matthew-the-king/RTU-Rocket-Telemetry-Unit-/README.md

# RTU-Rocket-Telemetry-Unit-
The RTU(Rocket Telemetry Unit) is an all-in-one solution for logging and transmitting data, plus controlling up to 3 servos. 



## Specifications
The RTU contains the following:<br>
MCU: STM32H725RGV6<br>
Barometer: BMP581<br>
IMU: BMI270<br>

For Power, the RTU has a 3.3V regulator and a 5v regulator for servos.<br>


## Recording Data
The RTU can record data to an SD card, provided that an SD card is inserted into the SD card port.<br>

## Transmitting Data
The RTU can transmit data through an on-board LoRa module; you must connect the appropriate u.fl antenna to the antenna port for the module to transmit.<br>

## Servo Control
The RTU can control up to three 5V servos; the servo ports can be found in these locations:<br>


## Production 
|Designator |Footprint |Quantity|Value | Link | Price |
|---|---|---|---|---|---|
|C10, C12, C19, C28, C36, C40 |0603 |6 |1uF | [Link](https://www.digikey.com/en/products/detail/kemet/C0603C105K4RACTU/2199788) | $0.83(Cheaper to buy 10) | 
|C11, C29, C30, C37, C38, C39 |0603 |6 |10uF | [Link](https://www.digikey.com/en/products/detail/murata-electronics/GRT188R61C106KE13D/5416739) | $1.75(Cheaper to buy 10)|
|C13, C14, C15, C16, C17, C18, C21, C22, C27, C3, C32, C34, C35, C4, C42, C43, C5, C6, C7, C8, C9|0402 |21 |0.1uF | [Link](https://www.digikey.com/en/products/detail/murata-electronics/GCM155R71H104KE02D/4903704) | $0.74 |
|C2, C49, C50 |0603 |3 |22uF | [Link](https://www.digikey.com/en/products/detail/samsung-electro-mechanics/CL10A226MO7JZNC/7320581) | $2.40 |
|C20, C31, C41, C46, C47, C48 |CAP_E61_CHC |6 |100uF | [Link](https://www.digikey.com/en/products/detail/chemi-con/APXG160ARA101ME61G/3983370) | $4.26 |
|C23, C24 |0603 |2 |2.2uF | [Link](https://www.digikey.com/en/products/detail/murata-electronics/GRM188R71A225KE15D/1033256) | $0.32 |
|C25, C26 |0402 |2 |10pF | [Link](https://www.digikey.com/en/products/detail/murata-electronics/GRM1555C1H100FA01D/2543854) | $0.20 |
|C33 |0603 |1 |4.7uF | [Link](https://www.digikey.com/en/products/detail/murata-electronics/GRM188R61E475KE11D/3900465) | $0.26 |
|C44 |0603 |1 |4700pF | [Link](https://www.digikey.com/en/products/detail/murata-electronics/GRM1885C1H472JA01D/4421616) | $0.12 | 
|C45 |0402 |1 |100pF | [Link](https://www.digikey.com/en/products/detail/murata-electronics/GRM1555C1H101GA01D/3693920) | $0.11 |
|D1 |0805 |1 |LED | [Link](https://www.digikey.com/en/products/detail/liteon/LTST-C170GKT/269226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) | $0.17 |
|FB1 |0603 |1 |120R | [Link](https://www.digikey.com/en/products/detail/pulse-electronics/PE-0603PFB121ST/5050544) | $0.10 |
|FPWM1, PFM1, R15, R16, R6, R7 |0402 |6 |10kΩ | [Link](https://www.digikey.com/en/products/detail/yageo/RC0402JR-0710KL/726418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) | $0.21(Cheaper to buy 10) |
|J1 |GCT_MEM2075-00-140-01-A |1 |MEM2075-00-140-01-A | [Link](https://www.digikey.com/en/products/detail/gct/MEM2075-00-140-01-A/9859614) | $1.92 |
|J2 |SAMESKY_UJ20-C-H-G-SMT-P16-TR |1 |UJ20-C-H-G-SMT-1-P16-TR| [Link](https://www.digikey.com/en/products/detail/same-sky-formerly-cui-devices/UJ20-C-H-G-SMT-P16-TR/24818595) | $0.65 |
|J4 |JST_B6B-XH-A |1 |B6B-XH-A | [Link](https://www.digikey.com/en/products/detail/jst-sales-america-inc/B6B-XH-A/1000381) | $0.23 |
|J5 |JST_B4B-XH-A |1 |B4B-XH-A | [Link](https://www.digikey.com/en/products/detail/jst-sales-america-inc/B4B-XH-A/1651047) | $0.17 |
|L1 |1008 |1 |1uH | [Link](https://www.digikey.com/en/products/detail/murata-electronics/DFE252012P-1R0M-P2/5247258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) | $0.22 |
|L2 |L_Wurth_WE-LHCA-1040 |1 |4.7uH | [Link](https://www.digikey.com/en/products/detail/w%C3%BCrth-elektronik/784373680047/24774011) | $3.35 |
|R1, R2 |0402 |2 |5.1kΩ | [Link](https://www.digikey.com/en/products/detail/yageo/RC0402FR-075K1L/726624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) | $0.20 |
|R10 |0402 |1 |330Ω | [Link](https://www.digikey.com/en/products/detail/yageo/RC0402FR-07330RL/726594) | $0.10 |
|R11, R12, R4, R5 |0402 |4 |4.7kΩ | [Link](https://www.digikey.com/en/products/detail/yageo/RC0402JR-074K7L/726477) | $0.21(Cheaper to buy 10) |
|R13 |0402 |1 |27.4kΩ | [Link](https://www.digikey.com/en/products/detail/yageo/RC0402FR-0727K4L/2827587) | $0.10 |
|R14 |0402 |1 |23.2kΩ | [Link](https://www.digikey.com/en/products/detail/panasonic-industry/ERJ-2RKF2322X/192235) | $0.10 |
|R3 |0402 |1 |0Ω | [Link](https://www.digikey.com/en/products/detail/panasonic-industry/ERJ-2GE0R00X/146727) | $0.10 |
|R8 |0603 |1 |511kΩ | [Link](https://www.digikey.com/en/products/detail/yageo/RC0603FR-07511KL/727288) | $0.10 |
|R9 |0603 |1 |91kΩ | [Link](https://www.digikey.com/en/products/detail/yageo/RC0603JR-0791KL/726841) | $0.10 |
|U1 |QFN-68-1EP_8x8mm_P0.4mm_EP6.4x6.4mm |1 |STM32H725RGVx | [Link](https://www.digikey.com/en/products/detail/stmicroelectronics/STM32H725RGV6/18085383) | $14.22 |
|U2 |QFN10_BMP581_BOS |1 |BMP581 | [Link](https://www.digikey.com/en/products/detail/bosch-sensortec/BMP581/16036134) | $3.35 |
|U3 |XDCR_BMI270 |1 |BMI270 | [Link](https://www.digikey.com/en/products/detail/bosch-sensortec/BMI270/9974486) | $4.23 |
|U4 |COMM-SMD_12P-L11.6-W11.0-P1.27_114993390|1 |WIO-SX1262_C9900174795 | [Link](https://www.digikey.com/en/products/detail/seeed-technology-co-ltd/114993390/25835823) | $5.95 |
|U5 |PSON50P145X100X60-6N |1 |TPD4S012DRYR | [Link](https://www.digikey.com/en/products/detail/texas-instruments/TPD4S012DRYR/2037539) | $1.19 |
|U6 |VAL0015A-MFG |1 |XTPS55285VALR | [Link](https://www.digikey.com/en/products/detail/texas-instruments/TPS55285VALR/28143335) | $4.15 |
|U7 |SOT50P160X60-8N |1 |TPS631000DRLR | [Link](https://www.digikey.com/en/products/detail/texas-instruments/TPS631000DRLR/15965499) | $2.20 |
|Y1 |CRYSTAL_ABM8G_ABR |1 |ABM8G-25.000MHZ-B4Y-T  | [Link](https://www.digikey.com/en/products/detail/abracon-llc/ABM8G-25-000MHZ-B4Y-T/2218043) | $0.86 |
||||||Total Price:$54.96 + plus shipping ~ $5.00|

For the PCB, I recommend using JLPCB; it costs only $8 for 5 boards plus shipping. 
## Firmware
Currently, there is no firmware because I do not have the board yet.

# Important Information
To ensure that the 3.3V regulator works correctly, make sure to place only ONE of the resistors circled; it is recommended to place the FPWM resistor and not the PFM resistor.<br>
