matthew-the-king/RTU-Rocket-Telemetry-Unit-/CAD/RTU(Rocket_Telementry_Unit).step

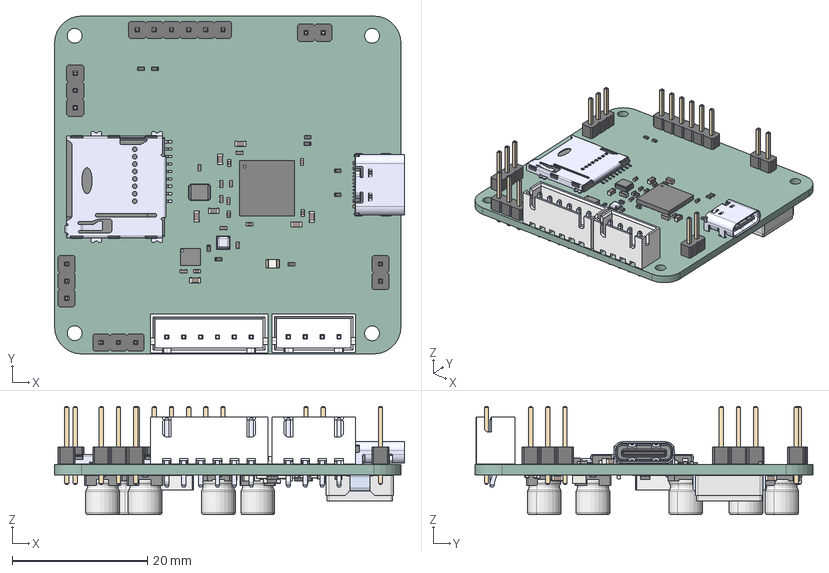
[picture p1: CAD file, 2026-11-01]
CAD/RTU(Rocket_Telementry_Unit).step
51.8 x 50.0 x 16.0 mm
C_0402_1005Metric x 24
C_0603_1608Metric x 19
R_0402_1005Metric x 16
BMP581
ABM8G
PinHeader_1x03_P254mm_Vertical x 3
MEM2075-00-140-01-A
BxB-XH-A_04
LED_0805_2012Metric
UJ20-C-H-G-SMT-1-P16-TR_UJ20-C-H-G-SMT-1-P16-TR
BxB-XH-A_06
PinHeader_1x02_P254mm_Vertical x 2
PinHeader_1x06_P254mm_Vertical
BMI270
L_0603_1608Metric
A-CHIP_D5_L5.8_ELEMENT x 6
A-CHIP_D5_LEAD- x 6
A-CHIP_D5_LEAD＋ x 6
A-CHIP_D5_TABLE x 6
R_0603_1608Metric x 2
DRY6
User_Library-IPEX
Extruded
pin
base
TPS2116DRLR
FRAME
MOLD
L_1008_2520Metric
RTU7DD6_PCB
