matthew-the-king/RTU-Rocket-Telemetry-Unit-/RTU(Rocket_Telementry_Unit).kicad_pcb

## KiCad design RTU(Rocket_Telementry_Unit).kicad_pcb (2026-11-06)

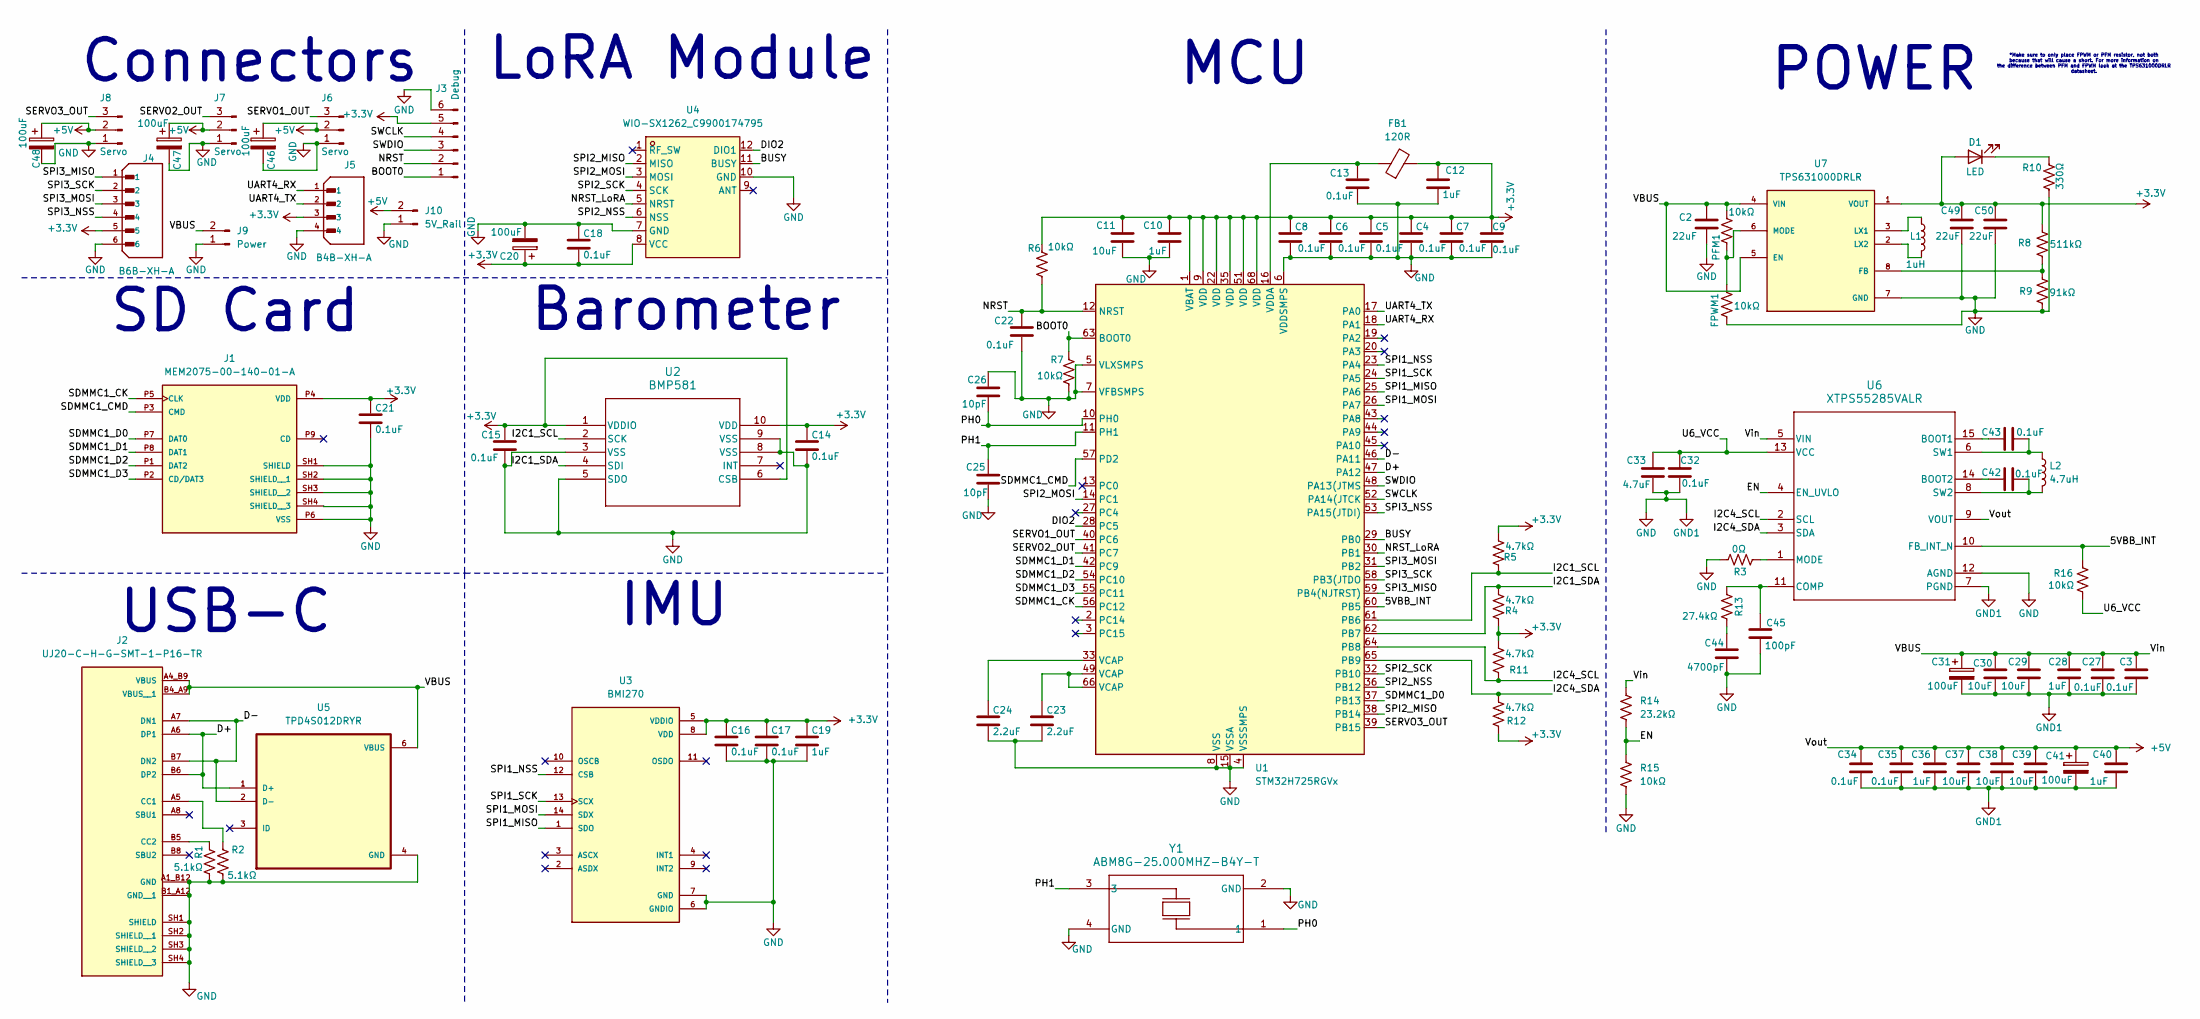
[picture p2: schematic RTU(Rocket_Telementry_Unit).kicad_sch]

Parts:
C2, C49, C50: 22uF; C_0603_1608Metric
C3, C4, C5, C6, C7, C8, C9, C13, C14, C15, C16, C17, C18, C21, C22, C27, C32, C34, C35, C42, C43: 0.1uF; C_0402_1005Metric
C10, C12, C19, C28, C36, C40: 1uF; C_0603_1608Metric
C11, C29, C30, C37, C38, C39: 10uF; C_0603_1608Metric
C20, C31, C41, C46, C47, C48: 100uF; CAP_E61_CHC
C23, C24: 2.2uF; C_0603_1608Metric
C25, C26: 10pF; C_0402_1005Metric
C33: 4.7uF; C_0603_1608Metric
C44: 4700pF; C_0603_1608Metric
C45: 100pF; C_0402_1005Metric
D1: LED; LED_0805_2012Metric
FB1: 120R; L_0603_1608Metric
FPWM1: 10kΩ; R_0402_1005Metric
J1: MEM2075-00-140-01-A; GCT_MEM2075-00-140-01-A; PARTREV A
J2: UJ20-C-H-G-SMT-1-P16-TR; SAMESKY_UJ20-C-H-G-SMT-P16-TR; PARTREV 1.0
J3: Debug; PinHeader_1x06_P2.54mm_Vertical
J4: B6B-XH-A; JST_B6B-XH-A; PARTREV 7/4/21
J5: B4B-XH-A; JST_B4B-XH-A; PARTREV 7/4/21
J6, J7, J8: Servo; PinHeader_1x03_P2.54mm_Vertical
J9: Power; PinHeader_1x02_P2.54mm_Vertical
J10: 5V_Rail; PinHeader_1x02_P2.54mm_Vertical
L1: 1uH; L_1008_2520Metric
L2: 4.7uH; L_Wurth_WE-LHCA-1040
PFM1: 10kΩ; R_0402_1005Metric
R1, R2: 5.1kΩ; R_0402_1005Metric
R3: 0Ω; R_0402_1005Metric
R4, R5, R11, R12: 4.7kΩ; R_0402_1005Metric
R6, R7, R15, R16: 10kΩ; R_0402_1005Metric
R8: 511kΩ; R_0603_1608Metric
R9: 91kΩ; R_0603_1608Metric
R10: 330Ω; R_0402_1005Metric
R13: 27.4kΩ; R_0402_1005Metric
R14: 23.2kΩ; R_0402_1005Metric
U1: STM32H725RGVx; QFN-68-1EP_8x8mm_P0.4mm_EP6.4x6.4mm
U2: BMP581; QFN10_BMP581_BOS
U3: BMI270; XDCR_BMI270
U4: WIO-SX1262_C9900174795; COMM-SMD_12P-L11.6-W11.0-P1.27_114993390; MPN Wio-SX1262; LCSC Part C9900174795
U5: TPD4S012DRYR; PSON50P145X100X60-6N
U6: XTPS55285VALR; VAL0015A-MFG
U7: TPS631000DRLR; SOT50P160X60-8N; PARTREV B
Y1: ABM8G-25.000MHZ-B4Y-T; CRYSTAL_ABM8G_ABR

Connections:
+3.3V: C4.1, C5.1, C6.1, C7.1, C8.1, C9.1, C10.1, C11.1, C12.1, C14.1, C15.1, C16.1, C17.1, C18.2, C19.1, C20.1, C21.1, C49.1, C50.1, D1.2 (A), FB1.2, J1.P4 (VDD), J3.5, J4.5, J5.3, R4.1, R5.2, R6.1, R8.2, R11.2, R12.1, U1.1 (VBAT), U1.9 (VDD), U1.22 (VDD), U1.35 (VDD), U1.51 (VDD), U1.68 (VDD), U2.1 (VDDIO), U2.6 (CSB), U2.10 (VDD), U3.5 (VDDIO), U3.8 (VDD), U4.8 (VCC), U7.1 (VOUT)
+5V: C34.1, C35.1, C36.1, C37.1, C38.1, C39.1, C40.1, C41.1, C46.1, C47.1, C48.1, J6.2, J7.2, J8.2, J10.2, U6.9 (VOUT)
/5VBB_INT: R16.1, U1.60 (PB5), U6.10 (FB_INT_N)
/BOOT0: J3.1, R7.1, U1.63 (BOOT0)
/BUSY: U1.29 (PB0), U4.11 (BUSY)
/D+: J2.A6 (DP1), J2.B6 (DP2), U1.47 (PA12), U5.1 (D+)
/D-: J2.A7 (DN1), J2.B7 (DN2), U1.46 (PA11), U5.2 (D-)
/DIO2: U1.28 (PC5), U4.12 (DIO1)
/EN: R14.2, R15.1, U6.4 (EN_UVLO)
/I2C1_SCL: R5.1, U1.61 (PB6), U2.2 (SCK)
/I2C1_SDA: R4.2, U1.62 (PB7), U2.4 (SDI)
/I2C4_SCL: R11.1, U1.64 (PB8), U6.2 (SCL)
/I2C4_SDA: R12.2, U1.65 (PB9), U6.3 (SDA)
/NRST: C22.1, J3.2, R6.2, U1.12 (NRST)
/NRST_LoRA: U1.30 (PB1), U4.5 (NRST)
/PH0: C26.2, U1.10 (PH0), Y1.1
/PH1: C25.1, U1.11 (PH1), Y1.3
/SDMMC1_CK: J1.P5 (CLK), U1.56 (PC12)
/SDMMC1_CMD: J1.P3 (CMD), U1.57 (PD2)
/SDMMC1_D0: J1.P7 (DAT0), U1.37 (PB13)
/SDMMC1_D1: J1.P8 (DAT1), U1.42 (PC9)
/SDMMC1_D2: J1.P1 (DAT2), U1.54 (PC10)
/SDMMC1_D3: J1.P2 (CD/DAT3), U1.55 (PC11)
/SERVO1_OUT: J6.3, U1.40 (PC6)
/SERVO2_OUT: J7.3, U1.41 (PC7)
/SERVO3_OUT: J8.3, U1.39 (PB15)
/SPI1_MISO: U1.25 (PA6), U3.1 (SDO)
/SPI1_MOSI: U1.26 (PA7), U3.14 (SDX)
/SPI1_NSS: U1.23 (PA4), U3.12 (CSB)
/SPI1_SCK: U1.24 (PA5), U3.13 (SCX)
/SPI2_MISO: U1.38 (PB14), U4.2 (MISO)
/SPI2_MOSI: U1.14 (PC1), U4.3 (MOSI)
/SPI2_NSS: U1.36 (PB12), U4.6 (NSS)
/SPI2_SCK: U1.32 (PB10), U4.4 (SCK)
/SPI3_MISO: J4.1, U1.59 (PB4(NJTRST))
/SPI3_MOSI: J4.3, U1.31 (PB2)
/SPI3_NSS: J4.4, U1.53 (PA15(JTDI))
/SPI3_SCK: J4.2, U1.58 (PB3(JTDO)
/SWCLK: J3.4, U1.52 (PA14(JTCK)
/SWDIO: J3.3, U1.48 (PA13(JTMS)
/U6_VCC: C32.1, C33.1, R16.2, U6.13 (VCC)
/UART4_RX: J5.1, U1.18 (PA1)
/UART4_TX: J5.2, U1.17 (PA0)
/VBUS: C2.1, C3.1, C27.1, C28.1, C29.1, C30.1, C31.1, J2.A4_B9 (VBUS), J2.A9_B4, J2.B4_A9 (VBUS__1), J9.2, PFM1.2, R14.1, U5.6 (VBUS), U6.5 (VIN), U7.4 (VIN), U7.5 (EN)
GND: C2.2, C3.2, C4.2, C5.2, C6.2, C7.2, C8.2, C9.2, C10.2, C11.2, C12.2, C13.2, C14.2, C15.2, C16.2, C17.2, C18.1, C19.2, C20.2, C21.2, C22.2, C23.2, C24.2, C25.2, C26.1, C27.2, C28.2, C29.2, C30.2, C31.2, C32.2, C33.2, C34.2, C35.2, C36.2, C37.2, C38.2, C39.2, C40.2, C41.2, C44.2, C45.2, C46.2, C47.2, C48.2, C49.2, C50.2, FPWM1.1, J1.P6 (VSS), J1.SH1 (SHIELD), J1.SH2 (SHIELD__1), J1.SH3 (SHIELD__2), J1.SH4 (SHIELD__3), J2.A1_B12 (GND), J2.A12_B1, J2.B1_A12 (GND__1), J2.SH1 (SHIELD), J2.SH2 (SHIELD__1), J2.SH3 (SHIELD__2), J2.SH4 (SHIELD__3), J3.6, J4.6, J5.4, J6.1, J7.1, J8.1, J9.1, J10.1, R1.2, R2.2, R3.2, R7.2, R9.1, R10.1, R15.2, U1.4 (VSSSMPS), U1.5 (VLXSMPS), U1.6 (VDDSMPS), U1.7 (VFBSMPS), U1.8 (VSS), U1.15 (VSSA), U1.21 (VSS), U1.34 (VSS), U1.50 (VSS), U1.67 (VSS), U1.69 (VSS), U2.3 (VSS), U2.5 (SDO), U2.8 (VSS), U2.9 (VSS), U3.6 (GNDIO), U3.7 (GND), U4.7 (GND), U4.10 (GND), U5.4 (GND), U6.7 (PGND), U6.12 (AGND), U7.7 (GND), Y1.2 (GND), Y1.4 (GND)
unnamed: C23.1, U1.49 (VCAP), U1.66 (VCAP)
unnamed: C24.1, U1.33 (VCAP)
unnamed: C44.1, R13.2
unnamed: D1.1 (K), R10.2
unnamed: J2.A5 (CC1), R2.1
unnamed: J2.B5 (CC2), R1.1
unnamed: C13.1, FB1.1, U1.16 (VDDA)
unnamed: C43.1, U6.15 (BOOT1)
unnamed: C42.1, U6.14 (BOOT2)
unnamed: C45.1, R13.1, U6.11 (COMP)
unnamed: R3.1, U6.1 (MODE)
unnamed: C43.2, L2.1, U6.6 (SW1)
unnamed: C42.2, L2.2, U6.8 (SW2)
unnamed: R8.1, R9.2, U7.8 (FB)
unnamed: L1.1, U7.3 (LX1)
unnamed: L1.2, U7.2 (LX2)
unnamed: FPWM1.2, PFM1.1, U7.6 (MODE)

Notes on the sheet:
POWER
MCU
LoRA Module
Connectors
Barometer
IMU
SD Card
USB-C
*Make sure to only place FPWM or PFM resistor, not both because that will cause a short. For more information on the difference between PFM and FPWM look at the TPS631000DRLR datasheet.

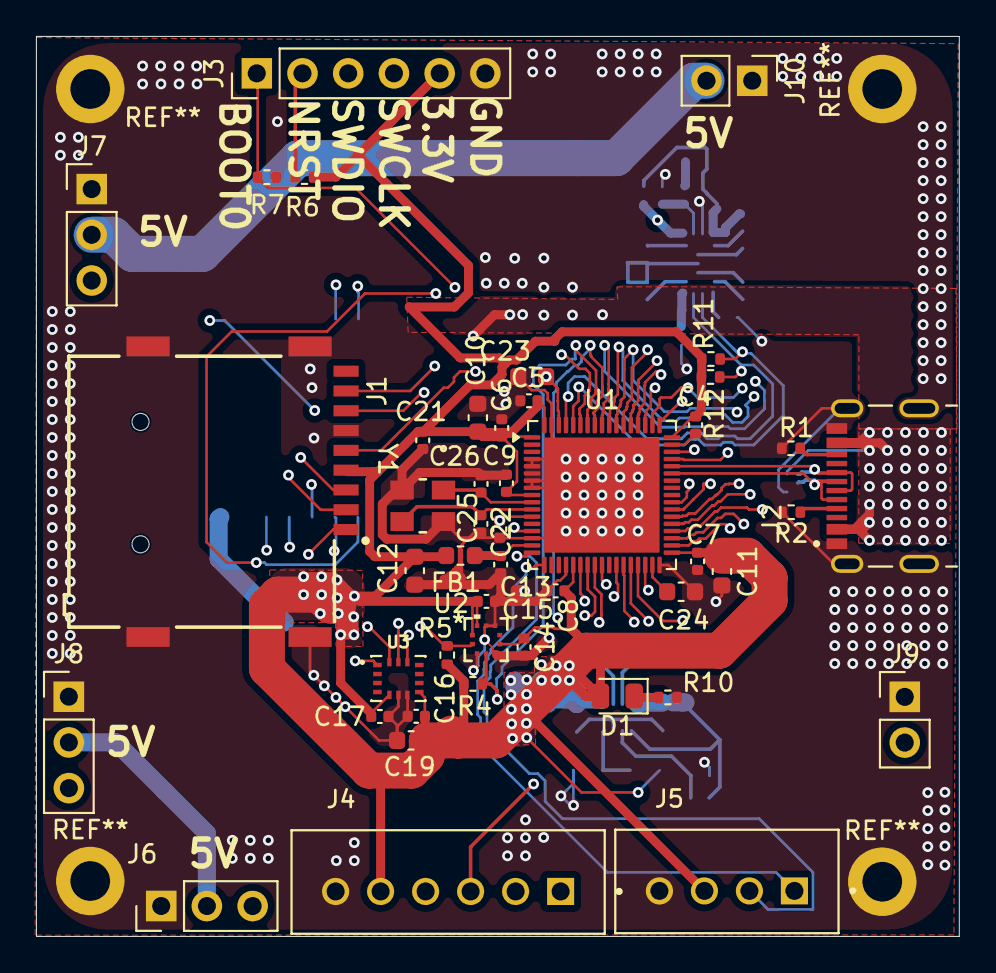
[picture p3: board RTU(Rocket_Telementry_Unit).kicad_pcb from above]

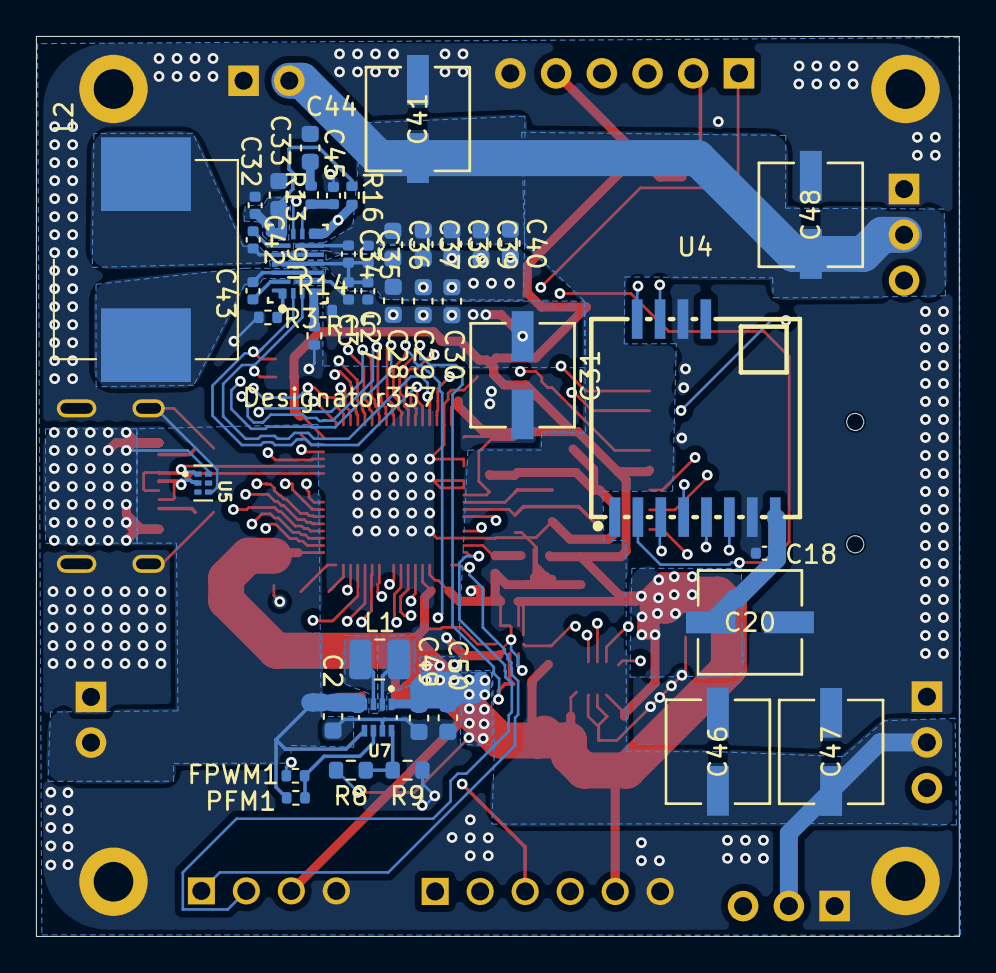
[picture p4: board RTU(Rocket_Telementry_Unit).kicad_pcb from below]

Board: 4 copper layers, 51.3 x 50.0 mm, 89 parts (43 on the bottom side), 62 nets.
