matthew-the-king/RTU-Rocket-Telemetry-Unit-/(commit log)

2026-11-01 added PCB
    [bom (1).csv, designators.csv, positions.csv]
2026-11-01 added CAD
    [RTU(Rocket_Telementry_Unit).step]
2026-11-01 Fix typo in resistor recommendation
2026-11-06 Enhance BOM with component links and pricing
    Updated BOM file to include links and prices for components.
    [bom (1).csv]
2026-11-06 Revise BOM with new components and pricing
    Updated BOM with additional components and prices.
    [bom (1).csv]
2026-11-06 Update bom (1).csv
    [bom (1).csv]
2026-11-06 Update BOM with new component prices and links
    [bom (1).csv]
2026-11-07 Update README with total price and PCB details
    Added total price for components and PCB recommendation.
